jpgrismeyer/ProyectoFinal/Sensor integral para el cuidado de plantas-20250406T194602Z-001/Sensor integral para el cuidado de plantas/Informe/Imagenes/bh1750.png

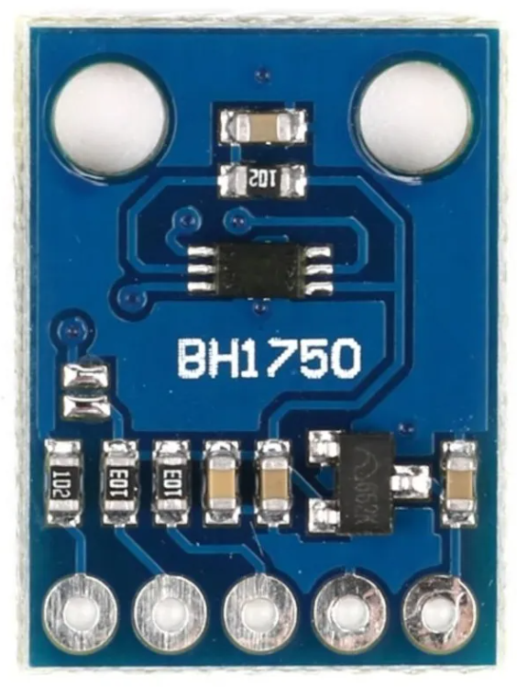
Sensor integral para el cuidado de plantas-20250406T194602Z-001/Sensor integral para el cuidado de plantas/Informe/Imagenes/bh1750.png
