jpgrismeyer/ProyectoFinal/Sensor integral para el cuidado de plantas-20250406T194602Z-001/Sensor integral para el cuidado de plantas/Sensor De Humedad De Sustrato.docx

# Sensor inteligente de humedad de sustrato de bajo costo

Sensor De Humedad De Sustrato - Xiaomi Mi Flora - Growing | Envío gratis (mercadolibre.com.ar) (https://articulo.mercadolibre.com.ar/MLA-1114325165-sensor-de-humedad-de-sustrato-xiaomi-mi-flora-growing-_JM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)

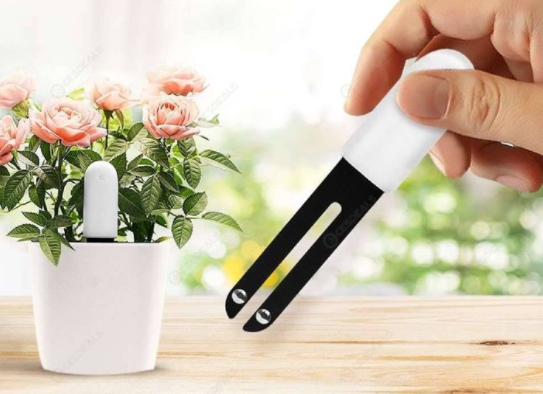
[picture p3: figure]

Sensor de humedad capacitivo:

Sensor De Humedad En Suelo - Capacitivo Analogico Gtia | MercadoLibre (https://articulo.mercadolibre.com.ar/MLA-806079200-sensor-de-humedad-en-suelo-capacitivo-analogico-gtia-_JM) ADC

Sensor de temperatura:

LM35 + acondicionamiento de señal (tarda 3 minutos en tener un valor 100% final) ADC

Termistor NTC + acondicionamiento de señal ADC

Sensor de luz:

Modulo Sensor De Luz Digital Ambiente Bh1750 Gy-302 Arduino | MercadoLibre (https://articulo.mercadolibre.com.ar/MLA-905448482-modulo-sensor-de-luz-digital-ambiente-bh1750-gy-302-arduino-_JM) I2C

LDR + acondicionamiento de señal (es necesario calibrar?) ADC

Microcontrolador:

Tiene que soportar: I2C, ADC (Ver STM32F103)

Display OLED:

Pantalla Oled Display 0.96p Arduino Raspberry Arm I2c Iic Se | MercadoLibre (https://articulo.mercadolibre.com.ar/MLA-743257264-pantalla-oled-display-096p-arduino-raspberry-arm-i2c-iic-se-_JM) I2C

Batería:

Accesorio Drone Bateria Litio Polimero Lipo 3.7v 2000mah | MercadoLibre (https://articulo.mercadolibre.com.ar/MLA-933373386-accesorio-drone-bateria-litio-polimero-lipo-37v-2000mah-_JM)
