jpgrismeyer/ProyectoFinal/Sensor integral para el cuidado de plantas-20250406T194602Z-001/Sensor integral para el cuidado de plantas/Presentación/Discurso.docx

Enzo:

Bienvenidos, gracias por asistir. Mi nombre es Enzo Manolucos y con mi compañero hoy presentaremos nuestro proyecto final de grado, llamado:

Sensor integral para el cuidado de plantas

Los temas tratados en esta presentación serán:

Introducción a la problemática y la solución propuesta

Objetivo del proyecto

Estado del arte, donde veremos los productos existentes

Diseño del sistema, nuestra propuesta para abordar la problemática

El dispositivo de medición que construimos

Y finalmente la aplicación final y conclusiones

Las plantas dentro del hogar nos generan la sensación de tener contacto con la naturaleza. Estas resultan de gran ayuda para las personas por diversos motivos, entre ellos tenemos:

Debido a esta necesidad cada vez es más común adquirir distintas especies de plantas. Algunas más conocidas son:

Potus, monstera, marginata, alocasia, calathea, suculentas, cactus, penca, etc.

Al tener tanta variedad de especies en el mercado, se necesitan distintos tipos de cuidados. Ciertas especies son muy caras de adquirir y lo que uno quiere es que la planta tenga un buen estado de salud.

Los principales problemas en el cuidado de salud de las plantas son:

Exceso de riego, quemaduras solares y/o demasiada luz

Es primordial acondicionar el ambiente hogareño al hábitat de la especie en cuestión

Por lo tanto el objetivo de nuestro proyecto es:

Desarrollar un dispositivo capaz de medir la luz incidente, humedad del sustrato, temperatura del sustrato y temperatura ambiente de una planta.

Con esta información el usuario va a tener detalles precisos de como cuidar y qué hacer con su planta.

En el mercado existen productos similares, con otras características. Principalmente estos necesitan de un smartphone para transmitir los datos, además de tener conexión WiFi. Xiaomi tiene Mi Flora con ronda los los 25 USD y Parrot tiene Flower Power que ronda los 50 USD.

Ver la filmina de grismeyer jeje.

El diseño del sistema se basa principalmente en sensores que toman datos de los plantos, su procesamiento y la visualización de la información para el usuario.

En base a esto los requerimientos propuestos son:
