jpgrismeyer/ProyectoFinal/Sensor integral para el cuidado de plantas-20250406T194602Z-001/Sensor integral para el cuidado de plantas/Informe/backup_30_06/ProyectoFinal_2022.pdf

### UNIVERSIDAD TECNOLOGICA NACIONAL ´

### FACULTAD REGIONAL CORDOBA ´

## Departamento de Ingeniería Electrónica

## Cátedra de Proyecto Final

## Informe

sensor integral para

el cuidado de plantas

## Integrantes

## Grismeyer, Juan Pablo Manolucos, Enzo Nicolas

## Director

## Riva, Guillermo

## Docentes

## Galleguillo, Juan Cayetano del Corazón Gaydou, David Encina, Lucas

# 1 de julio de 2022

## Juan Pablo Grismeyer - Enzo Nicolas Manolucos

Proyecto Final, © Julio 2022.

Cátedra de Proyecto Final | Informe

## Índice

1. Introducción | 3
2. Objetivo del proyecto | 4
3. Estado del arte | 5
3.1. Productos comerciales | | 5
3.2. Conclusión | | 5
4. Diseno del sistema | 6 ˜
4.1. Requerimientos | | 6
4.2. Etapas de desarrollo | | 7
5. Dispositivo de medición | 8
5.1. Prototipo I | | 8
5.2. Prototipo II | | 9
5.3. Diseño Final | | 9
| 5.3.1. Microcontrolador ESP8266 | | 9
| 5.3.2. Sensor de humedad y temperatura SHT20 | | 9
| 5.3.3. Sensor de luz BH1750 | | 9
| 5.3.4. Sensor de temperatura LM35 | | 9
| 5.3.5. Fuente de alimentación regulada | | 9
5.4. Firmware | | 9
6. Aplicación Final | 10
7. Conclusión | 11
8. Referencias | 12

## Figuras

1. | Plantas de interior | | 3
2. | Ejemplos de cuidado incorrecto de las plantas | | 4
3. | Productos comerciales | | 5
4. | PCB del prototipo I | | 8
5. | Esquemático del ESP8266 | | 9
6. | ESP8266 | | 10
7. | Esquemático de la fuente | | 10
8. | Diagrama en bloques del dispositivo | | 11

## Tablas

1. | Niveles de humedad, luz y temperatura según la especie | | 6

## 1. Introducción

En el contexto actual donde la sociedad pasa mayor tiempo dentro de sus hogares, se genera la necesidad de tener cierto contacto con la naturaleza a través de plantas dentro del mismo. Las plantas resultan de gran ayuda para el ser humano por diversos motivos, algunos son:

Limpian el ambiente y regulan la humedad

Ayudan contra el estrés y potencian la concentración

Tiene propiedades antisépticas y calmantes

Aportan una buena imagen en la decoración

Sirven para utilizar en comidas

Reducen el ruido

Ciertas especies ganaron más popularidad en estos últimos tiempos, como por ejemplo, potus, monstera, marginata, alocacia, sansevieras, calathea, suculentas, cactus, tradiscantia, penca, singonia, etc, algunas de las cuales se aprecian en la Figura 1.
Al tener tanta variedad de especies en el mercado, estas llevan distintos cuidados. Adquirir ciertas especies implica una elevada inversión y por lo tanto cuidarlas para mantenerlas saludables. Un mal cuidado puede derivar en la muerte de la misma.

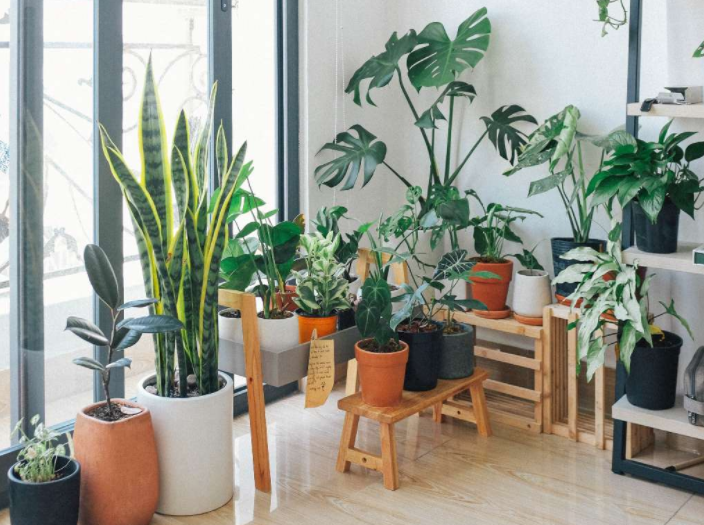
[picture p4: figure]

Figura 1: Plantas de interior.

La principal causa de muerte de las plantas de interior es el exceso de agua cuando se las riega. Un exceso de agua corta el suministro de airea a las raíces, elimina los nutrientes necesarios y crea el ambiente perfecto para hongos conduciendo a que se pudra la raíz (Figura 2a). Por otro lado, la falta de riego es tan perjudicial como el exceso de riego. Esto produce que las hojas se vean caídas, secas o que se pongan de color amarillo debido a que las plantas intentan conservar la poca agua que tienen para el tallo y raíces, descuidando las hojas. Existe una delgada linea entre riego excesivo y riego insuficiente por lo que es difícil medir las necesidades precisas de cada planta.
Al momento de cuidar plantas, lo ideal es tratar de imitar el entorno natural de estas. Por ejemplo, ciertas plantas que prosperan en el desierto necesitan sol pleno y poca agua, otras necesitan grandes niveles de humedad y sol indirecto para imitar un ambiente tropical. Un exceso de luz provoca que las hojas se curven hacia abajo, se doran las puntas o que las nuevas hojas sean más pequeñas que las anteriores (Figura 2b). Si por el contrario hay poca luz las hojas carecen de color y su tamaño es cada vez más pequeño.
La temperatura es otro factor a tener en cuenta. Las altas temperaturas y el exceso de luz directa pueden provocar quemaduras (Figura 2c), las cuales provoca daños irreparables y eventualmente la muerte de la planta. Temperaturas demasiada bajas dañan el crecimiento y provocan la muerte de las plantas.

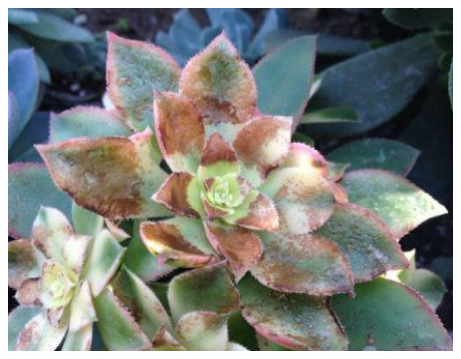
[picture p5: figure]
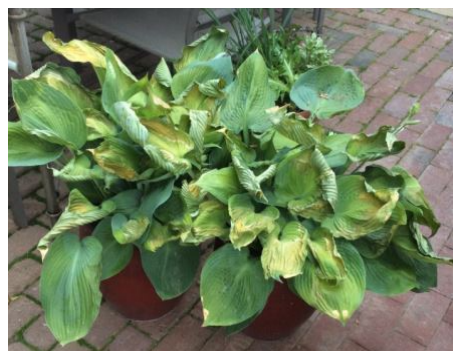
[picture p6: figure]
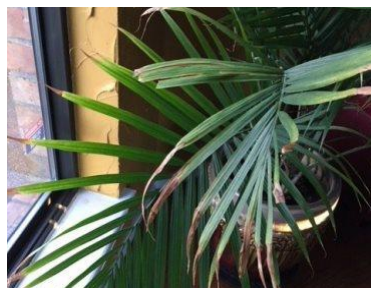
[picture p7: figure]

(a) Exceso de riego | (b) Demasiada luz | (c) Quemadura solar

Figura 2: Ejemplos de cuidado incorrecto de las plantas.

Estos tres factores son los más importantes al momento de cuidar una planta para conservar su estado de salud, su correcta reproducción y longevidad.

## 2. Objetivo del proyecto

Desarrollar un dispositivo capaz de medir la humedad del sustrato, temperatura ambiente y luz incidente sobre una planta, que pueda comunicar estos parámetros al usuario mediante una interfaz simple.

## 3. Estado del arte

Diversas empresas se dedican al desarrollo de sistemas aplicados al cuidado de plantas. Existen productos en fase de desarrollo y otros ya disponibles en el mercado. Estos se utilizan para el análisis y la toma de decisiones para el correcto cuidado de las plantas. Todos los productos actualmente en el mercado están sujetos a una aplicación móvil que permita visualizar los datos. La principal desventaja de esto es que se requiere de un teléfono móvil con conexión a internet y algún tipo de comunicación, ya sea WiFi o Bluetooth.

### 3.1. Productos comerciales

La empresa china Xiaomi posee en el mercado un dispositivo llamado Mi Flora (Figura 3a) que es utilizado para plantas de interior. Este tiene monitor de temperatura, humedad y detectores de luz y nutrientes. Su principal característica es la integración con IOT. El precio ronda los 25USD.
La empresa francesa Parrot posee en el mercado un dispositivo llamado Flower Power (Figura 3b) que también es utilizado para plantas de interior y exterior. Puede medir humedad, temperatura y luz. Además da recomendaciones de los cuidados de la planta según una base de datos. El precio ronda los 50USD.

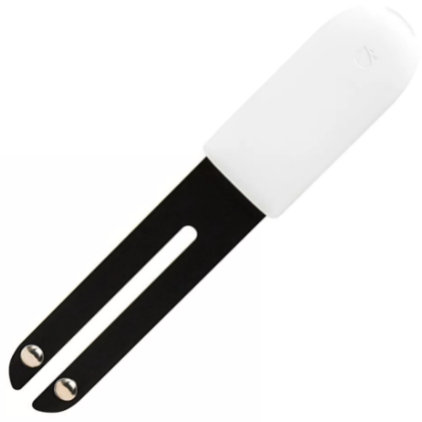
[picture p8: figure]
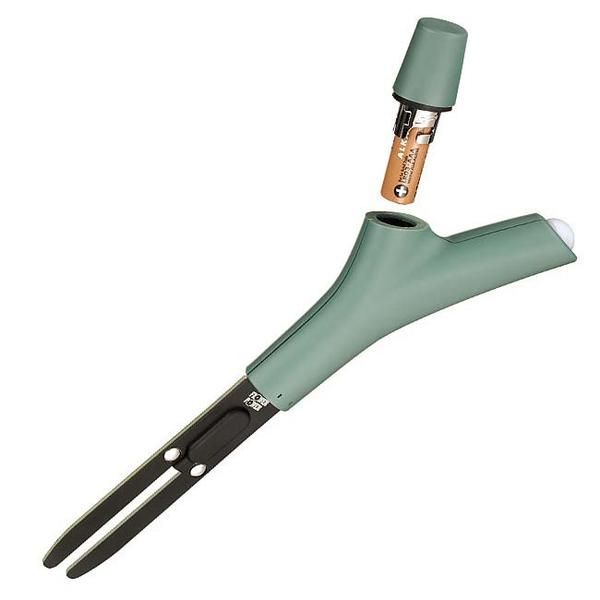
[picture p9: figure]

(a) Mi Flora | (b) Flower Power

Figura 3: Productos comerciales

### 3.2. Conclusión

Los productos del mercado relacionados a nuestro proyecto no son abundantes, principalmente en nuestro país. Además, su precio es elevado y la adquisición de la mayoría implica una importación. Esto representa una gran oportunidad en la introducción al mercado de nuestro producto, con la gran importancia que este posee en nuestro país.

## 4. Diseño del sistema

Como punto de partida, se propuso un sistema a nivel conceptual cuyo diagrama en bloques se muestra en la Figura . Este consistió en un conjunto

### 4.1. Requerimientos

En busca de un objetivo bien definitivo para el desarrollo del producto, se plantearon una serie de requerimientos para los diversos bloques del sistema. Esto permitiría en ele futuro a tener cierto grado de criterio al comparar tecnologías, dispositivos, fabricantes, entre otros aspectos. Se propone un sistema que mesure estos parámetros con sensores lo más simples posibles y fáciles de manipular, para que luego de acondicionar esas señales y del procesamiento de datos, el usuario pueda acceder a esta información de manera sencilla.
La idea es que el dispositivo integre los sensores necesarios y los circuitos acondicionadores para que mediante el control de un integrado, se ejecute las mediciones en una planta y se obtengan los datos en la interfaz de forma automática, en un corto lapso de tiempo.
El dispositivo está pensado para efectuar relevos individuales, es decir, controlar las variables de una planta a la vez. El usuario se debe encargar de hacer interactuar el dispositivo con el sustrato en cuestión, y una vez que ponga en marcha el sistema, en la interfaz entre el dispositivo y el usuario se exhiban de manera automática los datos requeridos.
El modelo en cuestión sólo informará acerca de los valores de los parámetros en cuestión, lo más preciso y rápido posible. El usuario debe saber como interpretar esos datos, si se adecúa a lo esperado y en que rango el parámetro en cuestión sería óptimo de acuerdo a las características de cada planta en específico.
Se tiene que obtener un producto que se pueda transportar de sustrato en sustrato para hacer las mediciones, que trabaje en condiciones ambientes de interior, y que su autonomía permita realizar las mediciones de las plantas del hogar de manera práctica y eficiente.
Segun [1], la humedad del sustrato/suelo se mide como el volumen de agua que hay en cierto volumen de tierra, se lo conoce como VWC, Contenido Volumétrico de Agua. En general, un nivel del 50 % se considera saturado, es decir, ya es demasiada agua en el sustrato para una planta. El dispositivo debe cumplir con los siguientes requerimientos:
Tipo | Humedad del sustrato | Luz | Temperatura [±2 ◦C]
Alocasia | Alta | Media (Ind) | 20 - 28
Cactus | Baja | Alta (Dir/Ind) | 5 - 35
Calathea | Media | Alta (Ind) | 18 - 24
Marginata | Media/Alta | Media (Ind) | 22 - 26
Monstera | Media/Alta | Alta (Ind) | 18 - 27
Penca | Baja | Alta (Dir/Ind) | 15 - 30
Potus | Alta | Alta (Ind) | 17 - 30
Sansevieria | Media | Alta (Dir) | 15 - 30
Suculentas | Media | Alta (Dir/Ind) | 4 - 27
Tradescantia Media | Alta (Ind) | 20 - 30

Tabla 1: Niveles de humedad, luz y temperatura según la especie.

Humedad del sustrato: Poder medir en un rango de 0 al 60 %. La precisión dentro de este rango de medición será del 5 %.

Temperatura: Poder realizar mediciones en el rango de 0°C a 50°C. La precisión dentro de este rango de medición será de al menos 0,5°C.

Luz: Poder medir de 0 a 20.000lx. La precisión dentro de este rango será de al menos 1 lx.

Condiciones de trabajo: Trabajar óptimamente con humedad ambiente relativa de 0 a 70 %.

Autonomía: 6hs mediante baterías.

Tamaño: Debe tener un tamaño mínimo así es posible manipularlo con una sola mano

Visualización de datos: Reflejar actualizaciones de los parámetros precisas al menos cada 10 segundos, de modo que no sea muy tediosa la adaptación y corrección de alguno de los factores que esté fuera de rango óptimo.

Tamaño

lo del anteproyecto

### 4.2. Etapas de desarrollo

Para llevara cabo el proyecto se propuso un esquema de dos etapas que permitiesen evaluar paso a paso las distintas alternativas y tecnologías que podrían dar solución a la problemática:

1. Etapa I: investigar y desarrollar un sistema para prueba de concepto. El objetivo fue analizar, en un periodo de tiempo muy corto, la factibilidad del producto sin tener en cuenta tecnologías ni requerimiento estrictos.
2. Etapa II: evaluar las tecnologías que cumplen los requerimientos planteados. Para esta etapa el objetivo planteado consistió en definir todas las tecnologías, circuitos y drivers para luego implementarlas en el producto final.
3. Etapa III: concentrar todos los circuitos implementados en la etapa anterior en un producto final.

## 5. Dispositivo de medición

El dispositivo electrónico portátil es el encargado de...
El desarrollo de este dispositivo constó de tres etapas. Cada una de estas perseguía distintos objetivos. La etapa inicial buscó evaluar la factibilidad de la idea. En la segunda etapa se evaluaron diversas tecnologías para la aplicación y se descartaron otras. Por último, en la tercera etapa se optimizaron los diseños realizados en las etapas anteriores y se diseñó un primer prototipo de producto.

### 5.1. Prototipo I

Primero se desarrollo este primer prototipo que tuve como objetivo evaluar la factibilidad del producto y seleccionar los sensores óptimos acordes a los requisitos del mismo.
El sensor propuesto para medir la humedad y temperatura del sustrato fue el SHT20. Este es un dispositivo electrónico combina un sensor capacitivo para la humedad, un sensor band gap de temperatura y un circuito analógica digital dedicado. El sensor propuesto para medir la luz fue el BH1750. Este dispositivo electrónico utiliza un sensor digital para medir la luz. Finalmente el sensor propuesto para medir la temperatura ambiente fue el LM35. Este dispositivo electrónico contiene un circuito integrado capaz de medir en Centígrados.
En esta etapa se diseño una plataforma con un microcontrolador que permitió interactuar con los sensores, registrar la información proveniente de los mismos y luego, mostrar estos datos en un display de 16x2. El diagrama en bloques de este prototipo se presenta en la Figura.
Se utilizo la plataforma Arduino UNO que contiene el microcontrolador ATmega328P, ya que el uso de esta arquitectura permite utilizar todas las funciones rápidamente debido a su gran desarrollo. Para la integración de todos los módulos comerciales, se diseño un PCB como el que se presenta en la Figura 4.

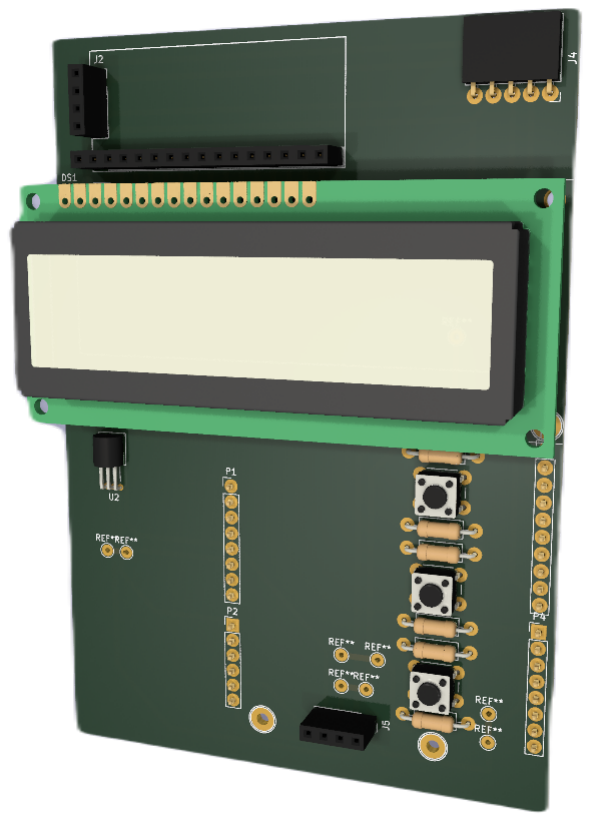
[picture p10: figure]

Figura 4: PCB del prototipo I.

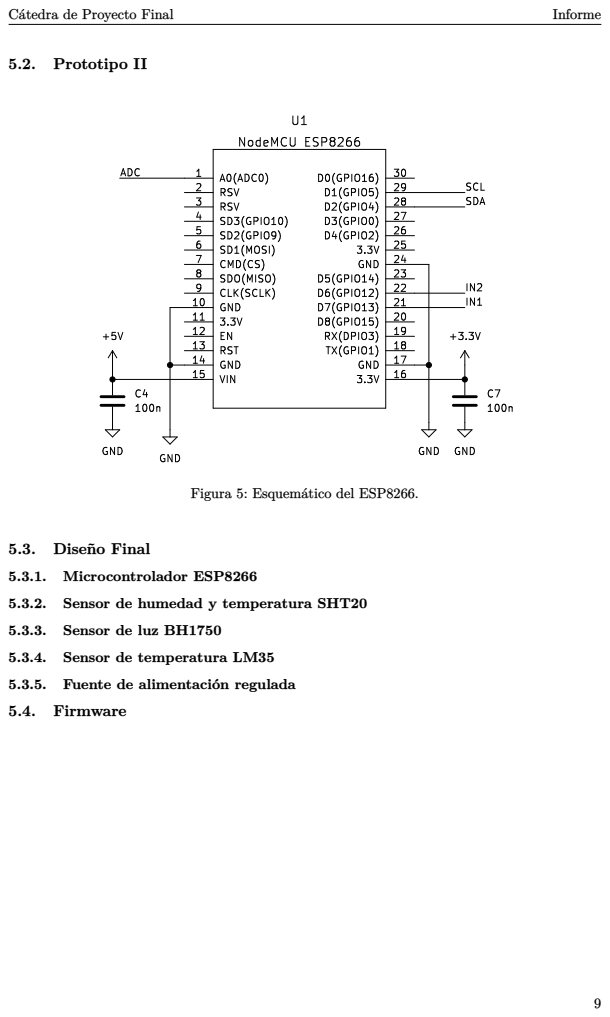
[picture p11: page 10]
5.2. Prototipo II; 5.3.1. Microcontrolador ESP8266; Sensor; de humedad; y temperatura SHT20; de luz BH1750; de temperatura LM35; Fuente; de alimentación regulada; 5.4. Firmware

Figura 5: Esquemático del ESP8266.

5.3. Diseño Final

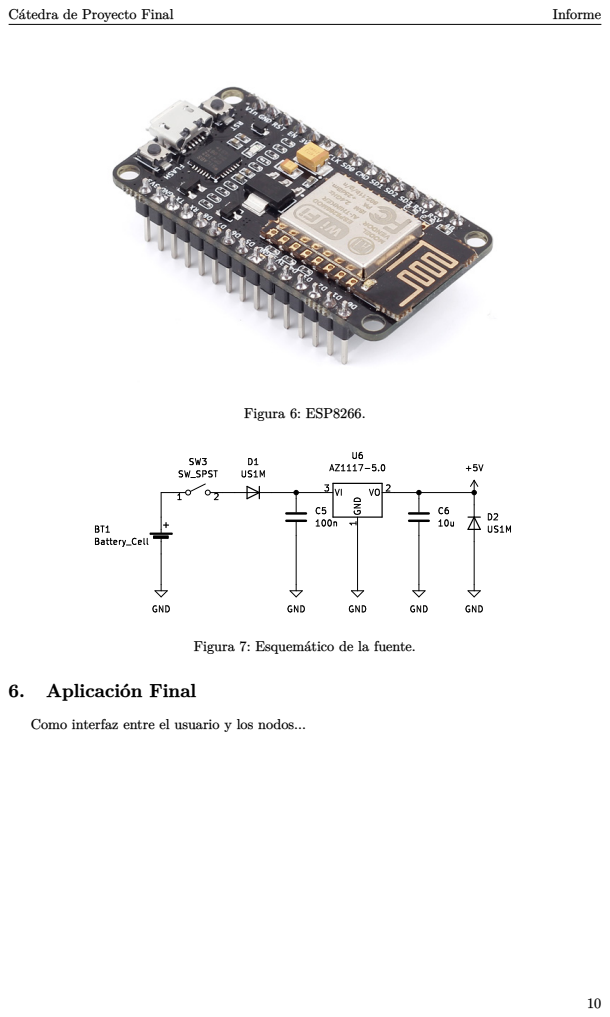
[picture p12: page 11]
Figura 6: ESP8266.

Figura 7: Esquemático de la fuente.

6. Aplicación Final

Como interfaz entre el usuario y los nodos...

## 7. Conclusión

En la Figura 8 se presenta el diagrama en bloques del dispositivo a desarrollar. A continuación se detalla la función de cada uno:

Sensores: se encargan de realizar la medición de las variables humedad, temperatura y luz.

- Humedad del sustrato: Se piensa en el sensor SHT20 que abarca el rango de medición requerido, y tiene una precisión del 3 %. El integrado se ubica dentro de un encapsulado especial para poder ser insertado en la tierra. Salida digital I²C.
- Temperatura: Se piensa en el sensor LM35 que abarca el rango de medición requerido, y tiene una precisión del 3°C. Salida analogica.
- Luz: Se elige el sensor GY-302, que trabaja con el chip BH1750, y tiene salida I2C. El sensor abarca el rango de medición requerido con una precisión de hasta 0,5 lx.

Acondicionamiento de señal: convierte la medición de los sensores en datos para luego ser procesados por el ADC en la etapa de control.

Control: adquiere y procesa los datos provenientes de los sensor para obtener las mediciones. Cuenta con ADC y protocolo de comunicación I²C.

Interfaz: sera la interfaz entre el usuario y el dispositivo para poder iniciar y configurarlo. Posee una pantalla OLED con comunicación I²C o SPI y pulsadores para el manejo de la

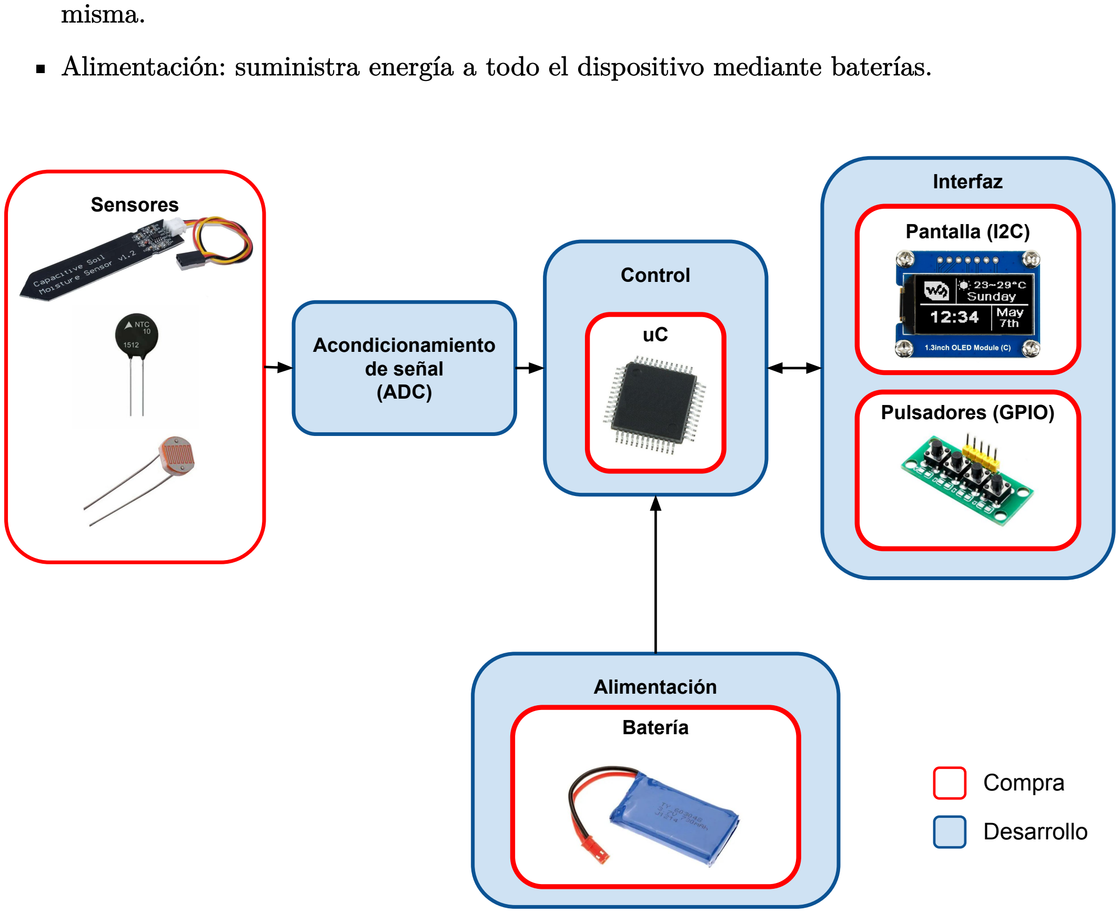
[picture p13: figure]
misma.; Sensores; Acondicionamiento de señal (ADC); Control; Interfaz; Pantalla (I2C); Pulsadores (GPIO); Alimentación; Batería; Compra; Desarrollo

Alimentación: suministra energía a todo el dispositivo mediante baterías.

Figura 8: Diagrama en bloques del dispositivo.

Cosas que hay que poner Glosario, Anexo

## 8. Referencias

[1] Franco Castro, Mayco Cussa, Facundo Navarro, and Jonathan Nobile. Monitoreo de variables de suelo para control fúngico en campos de azafrán. UTN - Facultad Regional Córdoba, 2021.
