jpgrismeyer/ProyectoFinal/Sensor integral para el cuidado de plantas-20250406T194602Z-001/Sensor integral para el cuidado de plantas/dibujo_prototipo_JE.pdf

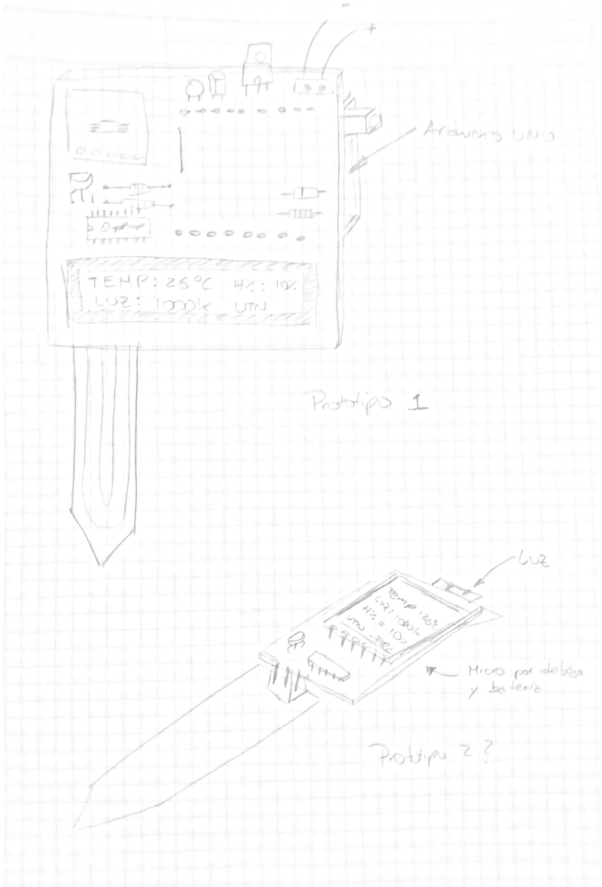
[picture p14: page 1]
