jpgrismeyer/ProyectoFinal/Sensor integral para el cuidado de plantas-20250406T194602Z-001/Sensor integral para el cuidado de plantas/Anteproyecto/Gantt_Grismeyer_Manolucos_actualizado.pdf

1 | Proyecto Final de Grado | 87 days? | 01/04/22 08:00 | 08/07/22 17:00
2 | Etapa I | 43 days? | 01/04/22 08:00 | 13/05/22 17:00
3 | relevar sensores | 7 days? | 01/04/22 08:00 | 07/04/22 17:00
4 | comprar | 4 days? | 08/04/22 08:00 | 11/04/22 17:00 | 3
5 | prueba individual de cada sensor | 2 days? | 12/04/22 08:00 | 13/04/22 17:00 | 4
6 | calibración | 2 days? | 12/04/22 08:00 | 13/04/22 17:00 | 4
7 | acondicionamiento de señales p/ arduino | 3 days? | 14/04/22 08:00 | 16/04/22 17:00 | 6;5
8 | diseño | 8 days? | 17/04/22 08:00 | 24/04/22 17:00 | 7
9 | compra de componentes | 4 days? | 25/04/22 08:00 | 28/04/22 17:00 | 8
10 | programación arduino | 11 days? | 29/04/22 08:00 | 09/05/22 17:00 | 9
11 | montaje prototipo 1 | 12 days? | 29/04/22 08:00 | 10/05/22 17:00 | 9
12 | evaluacion prototipo 1 | 15 days? | 29/04/22 08:00 | 13/05/22 17:00 | 9
13 | Etapa II | 44 days? | 14/05/22 08:00 | 08/07/22 17:00 | 12
14 | identificar fallas en prototipo 1 | 4 days? | 14/05/22 08:00 | 17/05/22 17:00
15 | relevar micros | 4 days? | 14/05/22 08:00 | 17/05/22 17:00
16 | diseñar prototipo 2 con mejoras y acord... | 8 days? | 18/05/22 08:00 | 25/05/22 17:00 | 15;14
17 | comprar micro | 4 days? | 26/05/22 08:00 | 31/05/22 17:00 | 16
18 | diseñar pcb | 5 days? | 01/06/22 08:00 | 07/06/22 17:00 | 16;17
19 | comprar demás componentes | 2 days? | 08/06/22 08:00 | 09/06/22 17:00 | 18
20 | confeccionar placa | 5 days? | 10/06/22 08:00 | 16/06/22 17:00 | 19
21 | soldar | 2 days? | 17/06/22 08:00 | 20/06/22 17:00 | 20
22 | pruebas y presentar | 4 days? | 21/06/22 08:00 | 24/06/22 17:00 | 21
23 | Confeccion de informe | 5 days? | 27/06/22 08:00 | 01/07/22 17:00 | 22
24 | Presentación | 1 day? | 08/07/22 08:00 | 08/07/22 17:00 | 23
Nombre | Duracion | Inicio | Terminado | Predecesores | Nombres del Recurso
M | M | J | V | S | D | L

4 abr 22
M | M | J | V | S | D | L

11 abr 22
M | M | J | V | S | D | L

18 abr 22
M | M | J | V | S | D | L

25 abr 22
M | M | J | V | S | D | L

2 may 22
M | M | J | V | S | D | L

9 may 22
M | M | J | V | S | D | L

16 may 22
M | M | J | V | S | D | L

23 may 22
M | M | J | V | S | D | L

30 may 22
M | M | J | V | S | D | L

6 jun 22
M | M | J | V | S | D | L

13 jun 22
M | M | J | V | S | D | L

20 jun 22
M | M | J | V | S | D | L

27 jun 22
M | M | J | V | S | D | L

4 jul 22
M | M | J | V | S | D | L
