jpgrismeyer/ProyectoFinal/Sensor integral para el cuidado de plantas-20250406T194602Z-001/Sensor integral para el cuidado de plantas/Informe/Imagenes/Anotación 2022-06-30 182313.png

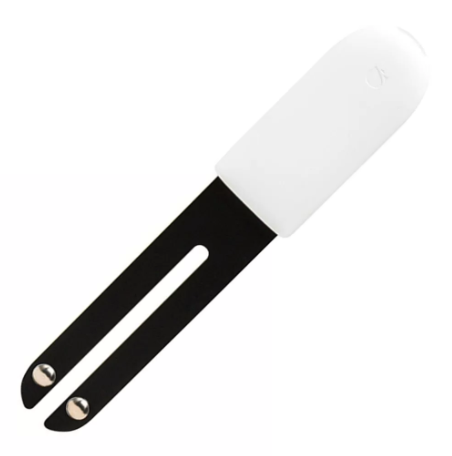
Sensor integral para el cuidado de plantas-20250406T194602Z-001/Sensor integral para el cuidado de plantas/Informe/Imagenes/Anotación 2022-06-30 182313.png
