jpgrismeyer/ProyectoFinal/Sensor integral para el cuidado de plantas-20250406T194602Z-001/Sensor integral para el cuidado de plantas/Presentación/Fotos/WhatsApp Image 2022-07-08 at 10.47.06 AM (1).jpeg

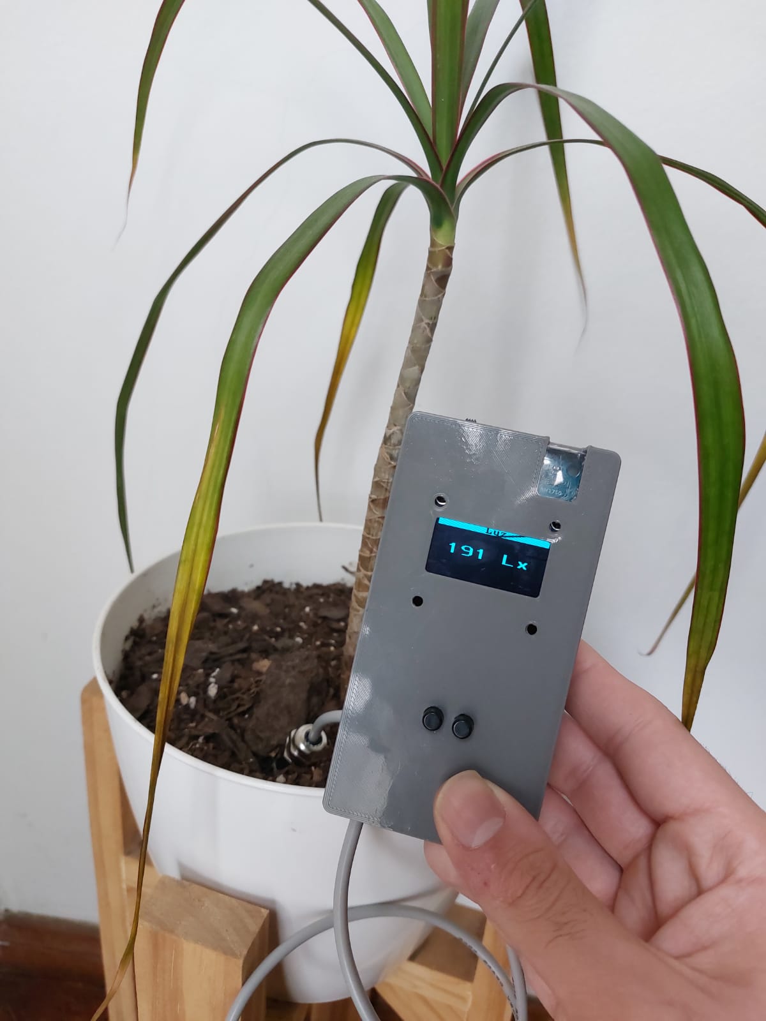
Sensor integral para el cuidado de plantas-20250406T194602Z-001/Sensor integral para el cuidado de plantas/Presentación/Fotos/WhatsApp Image 2022-07-08 at 10.47.06 AM (1).jpeg
