jpgrismeyer/ProyectoFinal/Sensor integral para el cuidado de plantas-20250406T194602Z-001/Sensor integral para el cuidado de plantas/Materiales.xlsx

Sheet: Compras feriado
Componente | Cantidad | Comentario
Hojas termotrasferencia A4 | 3 | Puede ser de otro tamaño. En Celsius tenian oficio
Placa FR4 20x10cm | 1 | Tamaño minimo
Tira de pines hembra 1x40 | 2
Switch pulsador largo | 3 | Hay unos con e boton más largo para meter en el gabitene. Alfa tiene ->
SHT20 con encalsupado | 1 | $8100, llega entre 27 y 30 de Junio

Sheet: SMD
Componente | Encapsulado | Cantidad | Link
Regulador AMS1117 5V | SOT-223 | 10
Capacitor 100n Y5V | 1206 | 100
Resistor 10k | 1206 | 100
Resistor 220 | 1206 | 100
Diodo S1M | DO-214 | 25
Bateria Lipo 7.4v 1500mah Drones | MercadoLibre (https://articulo.mercadolibre.com.ar/MLA-736416606-bateria-lipo-74v-1500mah-drones-_JM)
Componente
Alimentacion
Conector

Sheet: Compras
 | Enzo | Juan Pablo
Sensor SHT20 (con carcasa) | 8100
Componentes SMD | 3600
Mechas 0,5 y 1mm | 800
ESP8266 | 1634
Display OLED | 1914
Componentes (pinza y conectores) | 1651
Gabinete 3D | 700
Sensor SHT20 |  | 2654
Módulo I2C LCD |  | 376
Lm35 |  | 320
BH1750 (luz) |  | 701
Display OLED 2 | 2185
Carcasas |  | 1950
hojas, placa, tiras hembra |  | 974
tornillos, acetato |  | 270 | TOTAL | 27829
Gasto cada uno | 20584 | 7245
Debe | -6669.5 | 6669.5
