jpgrismeyer/ProyectoFinal/Sensor integral para el cuidado de plantas-20250406T194602Z-001/Sensor integral para el cuidado de plantas/Etapa II/Prototipo 3D/otras versiones/proyecto final tapa b.FCStd

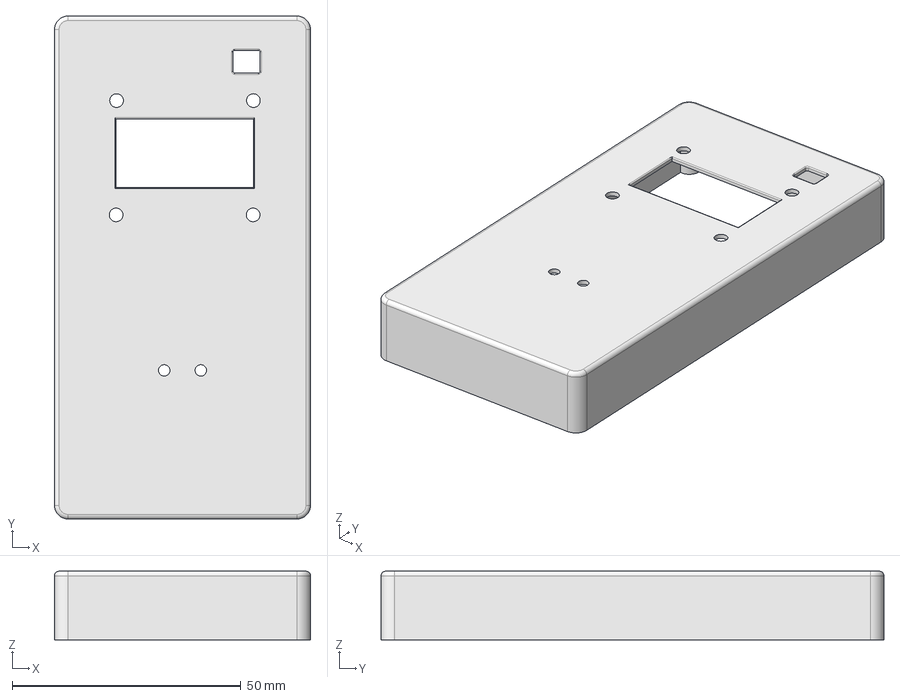
[picture p45: CAD file, 2025-04-06]
Sensor integral para el cuidado de plantas-20250406T194602Z-001/Sensor integral para el cuidado de plantas/Etapa II/Prototipo 3D/otras versiones/proyecto final tapa b.FCStd
56.0 x 110.0 x 15.0 mm
