jpgrismeyer/ProyectoFinal/(list of files, cad)

Other CAD files:
Sensor integral para el cuidado de plantas-20250406T194602Z-001/Sensor integral para el cuidado de plantas/Etapa II/Prototipo 3D/otras versiones/proyecto final base b.FCStd
Sensor integral para el cuidado de plantas-20250406T194602Z-001/Sensor integral para el cuidado de plantas/Etapa II/Prototipo 3D/proyecto final tapa c-Body.stl
Sensor integral para el cuidado de plantas-20250406T194602Z-001/Sensor integral para el cuidado de plantas/Etapa II/Prototipo 3D/otras versiones/proyecto final tapa c.FCStd
Sensor integral para el cuidado de plantas-20250406T194602Z-001/Sensor integral para el cuidado de plantas/Etapa II/Prototipo 3D/proyecto final tapa c.FCStd
Sensor integral para el cuidado de plantas-20250406T194602Z-001/Sensor integral para el cuidado de plantas/Etapa II/Prototipo 3D/proyecto final base b-Body.stl
