jpgrismeyer/ProyectoFinal/Sensor integral para el cuidado de plantas-20250406T194602Z-001/Sensor integral para el cuidado de plantas/Informe/Imagenes/bloques_prot1.pdf

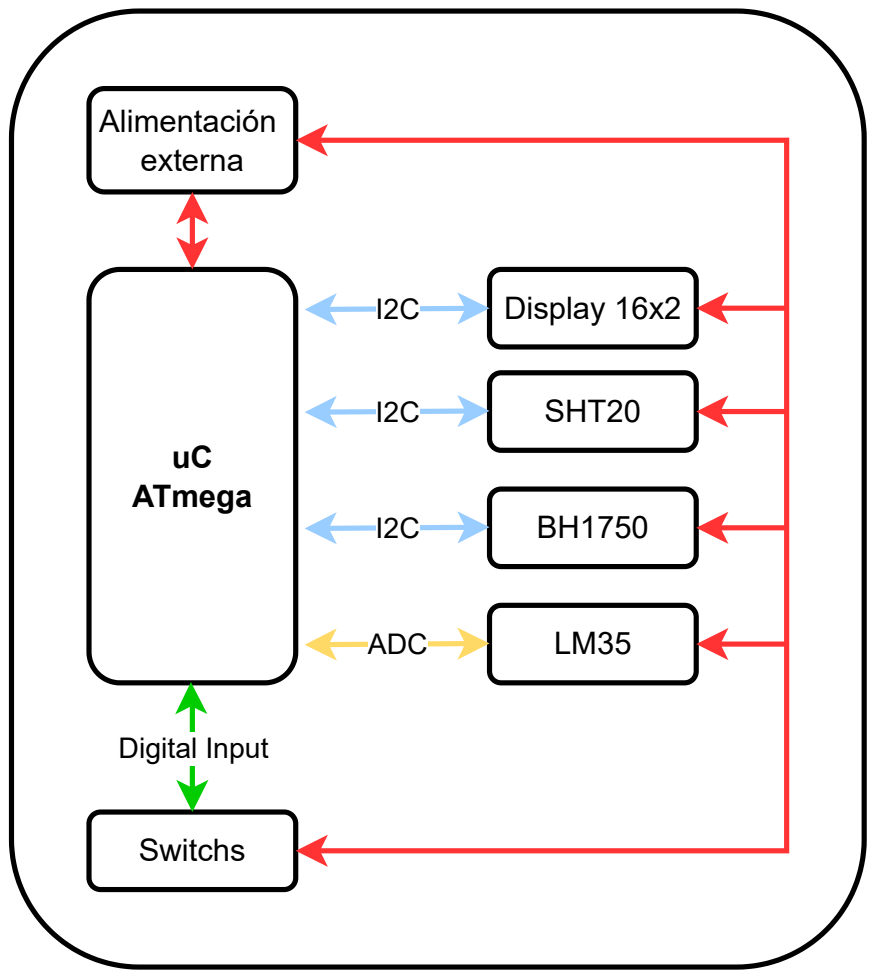
[picture p47: page 1]
uC ATmega; SHT20; Display 16x2; Alimentación externa; Switchs; ADC; Digital Input
