jpgrismeyer/ProyectoFinal/Sensor integral para el cuidado de plantas-20250406T194602Z-001/Sensor integral para el cuidado de plantas/Informe/Imagenes/bloques_prot2.pdf

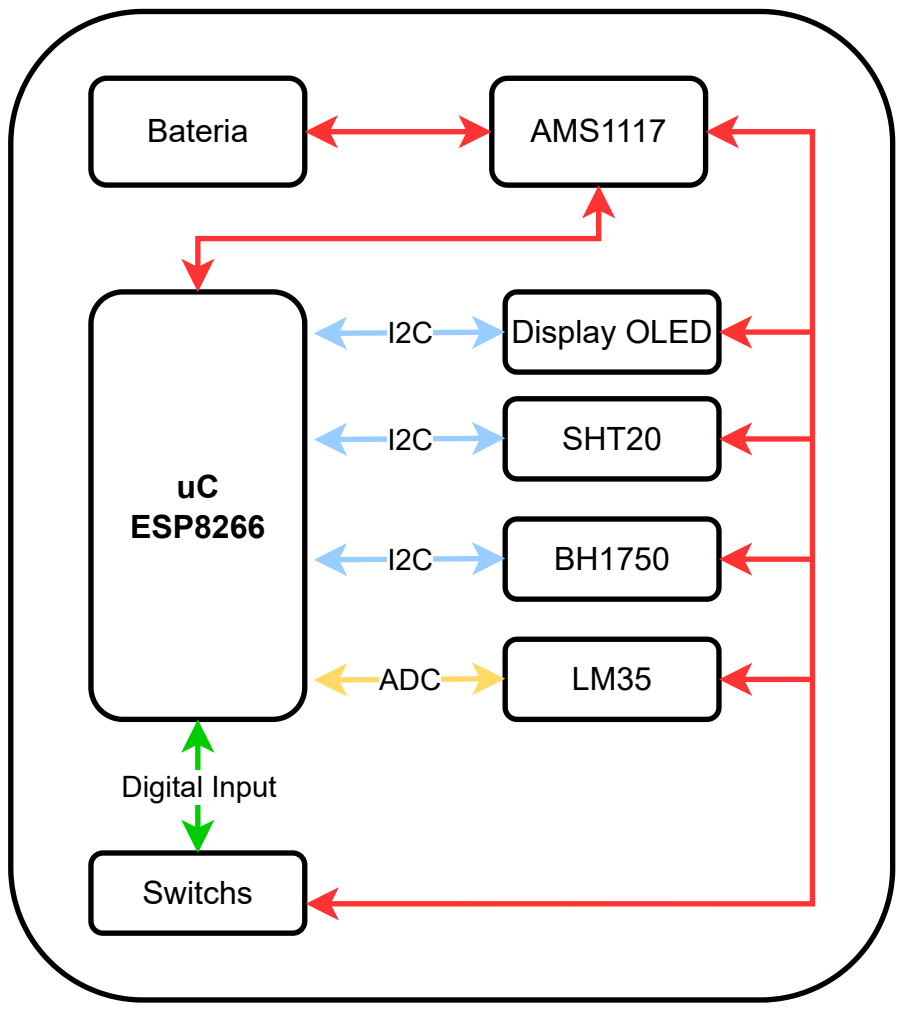
[picture p48: page 1]
uC ESP8266; SHT20; Display OLED; Bateria; Switchs; ADC; Digital Input; AMS1117
