jpgrismeyer/ProyectoFinal/Sensor integral para el cuidado de plantas-20250406T194602Z-001/Sensor integral para el cuidado de plantas/Informe/Imagenes/Draw.io/sistema.pdf

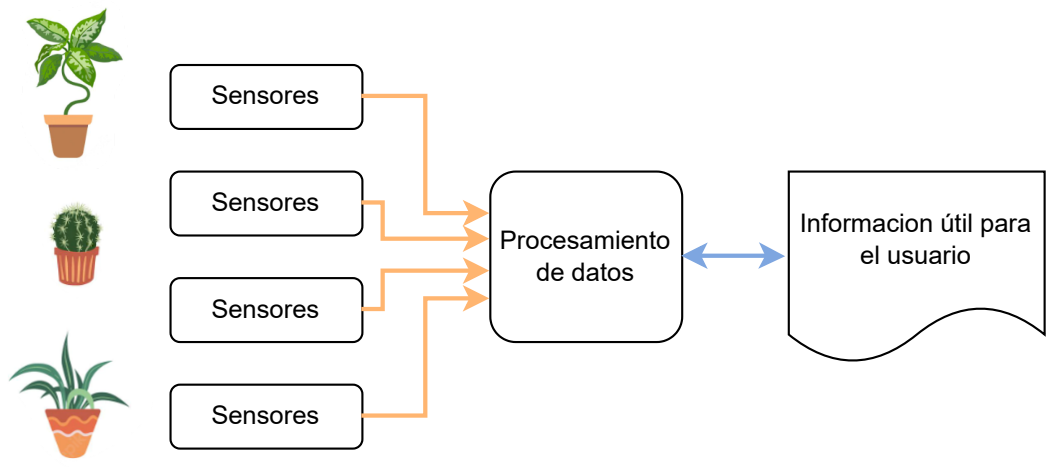
[picture p50: page 1]
Sensores; Procesamiento de datos

Informacion útil para
el usuario
