jpgrismeyer/ProyectoFinal/Sensor integral para el cuidado de plantas-20250406T194602Z-001/Sensor integral para el cuidado de plantas/Etapa II/Schematic_v1.pdf

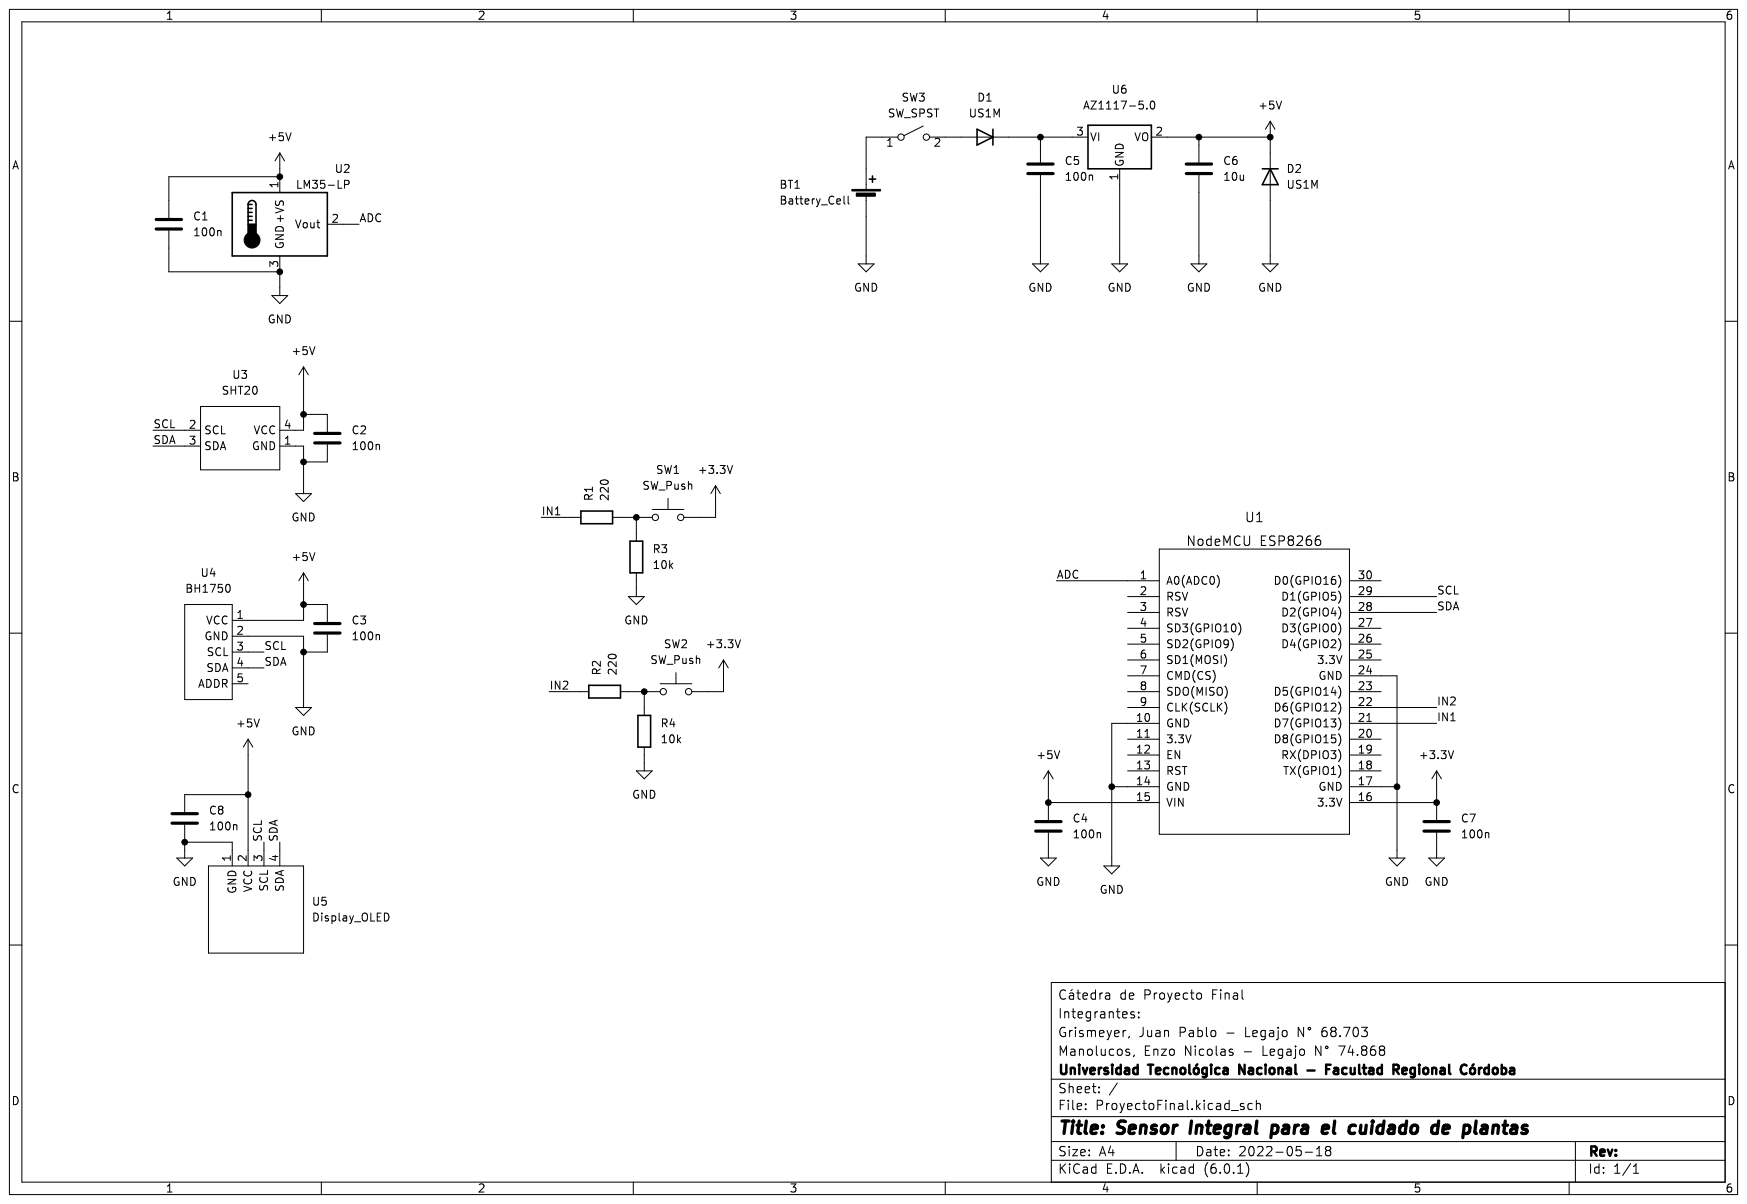
[picture p51: page 1]
