jpgrismeyer/ProyectoFinal/Sensor integral para el cuidado de plantas-20250406T194602Z-001/Sensor integral para el cuidado de plantas/Anteproyecto/Carátula_Grismeyer_Manolucos.pdf

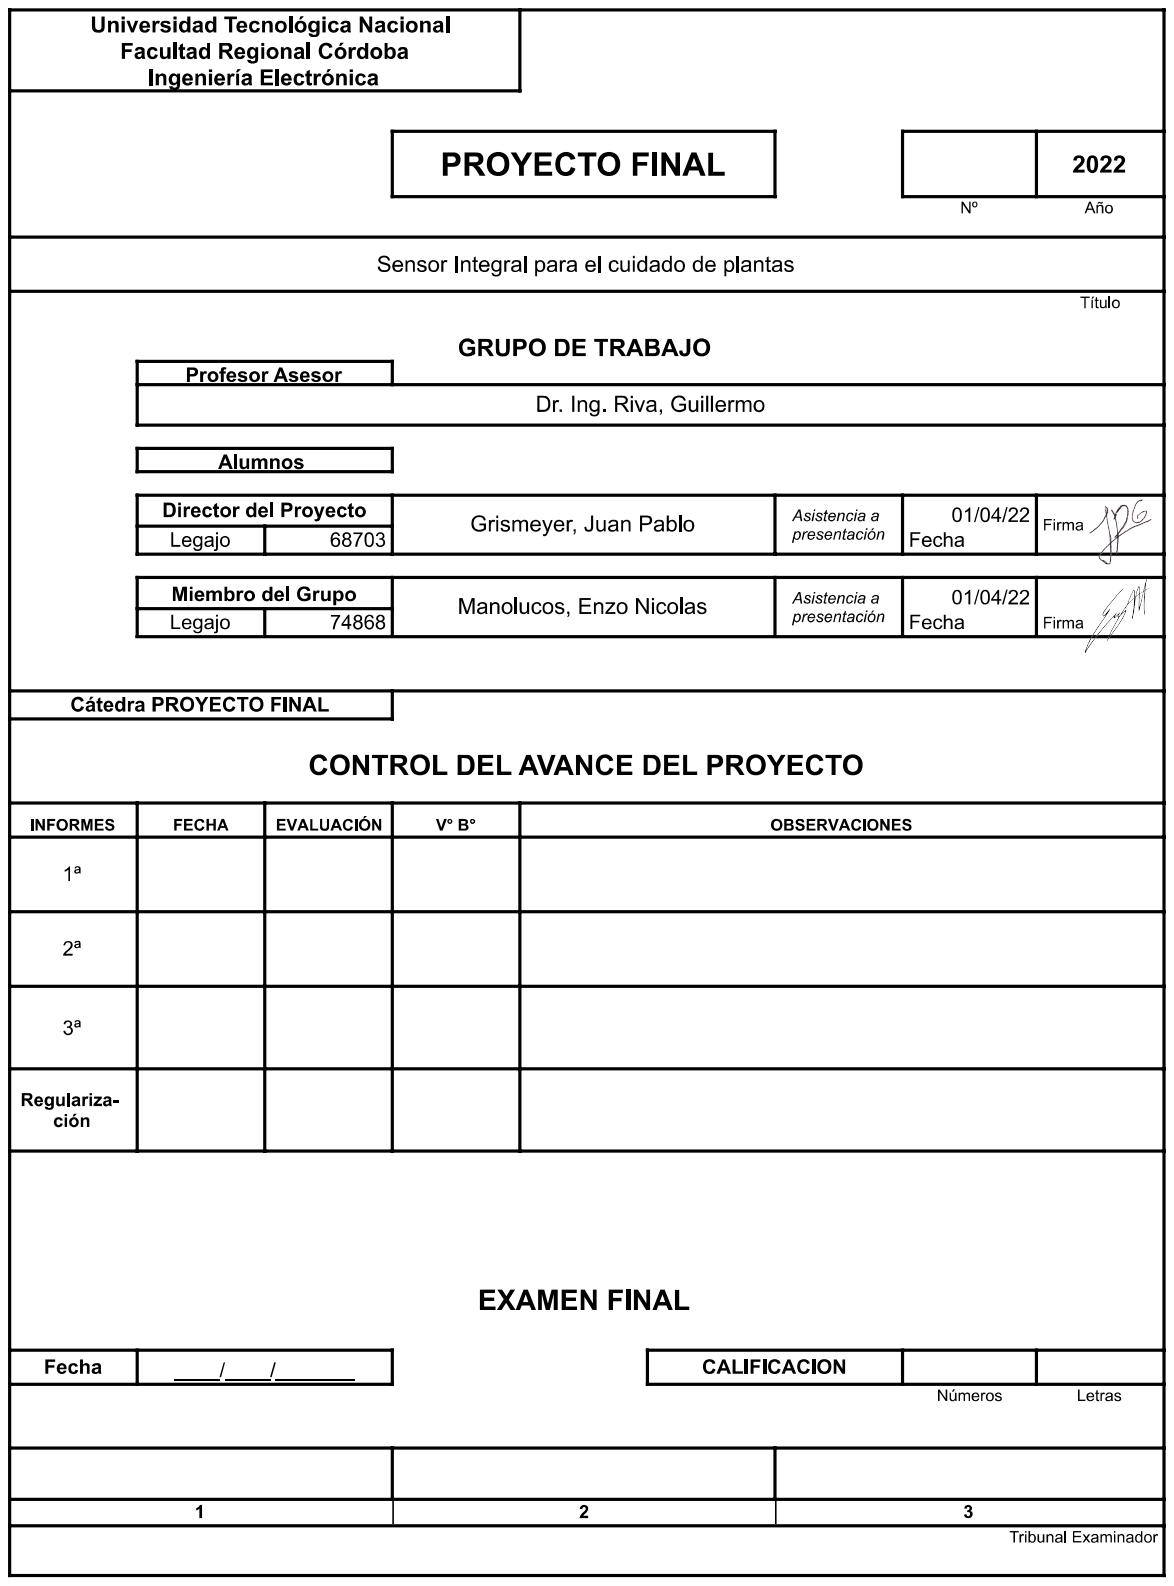
[picture p56: page 1]
