jpgrismeyer/ProyectoFinal/Sensor integral para el cuidado de plantas-20250406T194602Z-001/Sensor integral para el cuidado de plantas/Etapa II/PCB_V1/ProyectoFinal/ProyectoFinal.kicad_pcb

## KiCad design Sensor integral para el cuidado de plantas-20250406T194602Z-001/Sensor integral para el cuidado de plantas/Etapa II/PCB_V1/ProyectoFinal/ProyectoFinal.kicad_pcb (2025-04-06, an earlier design)

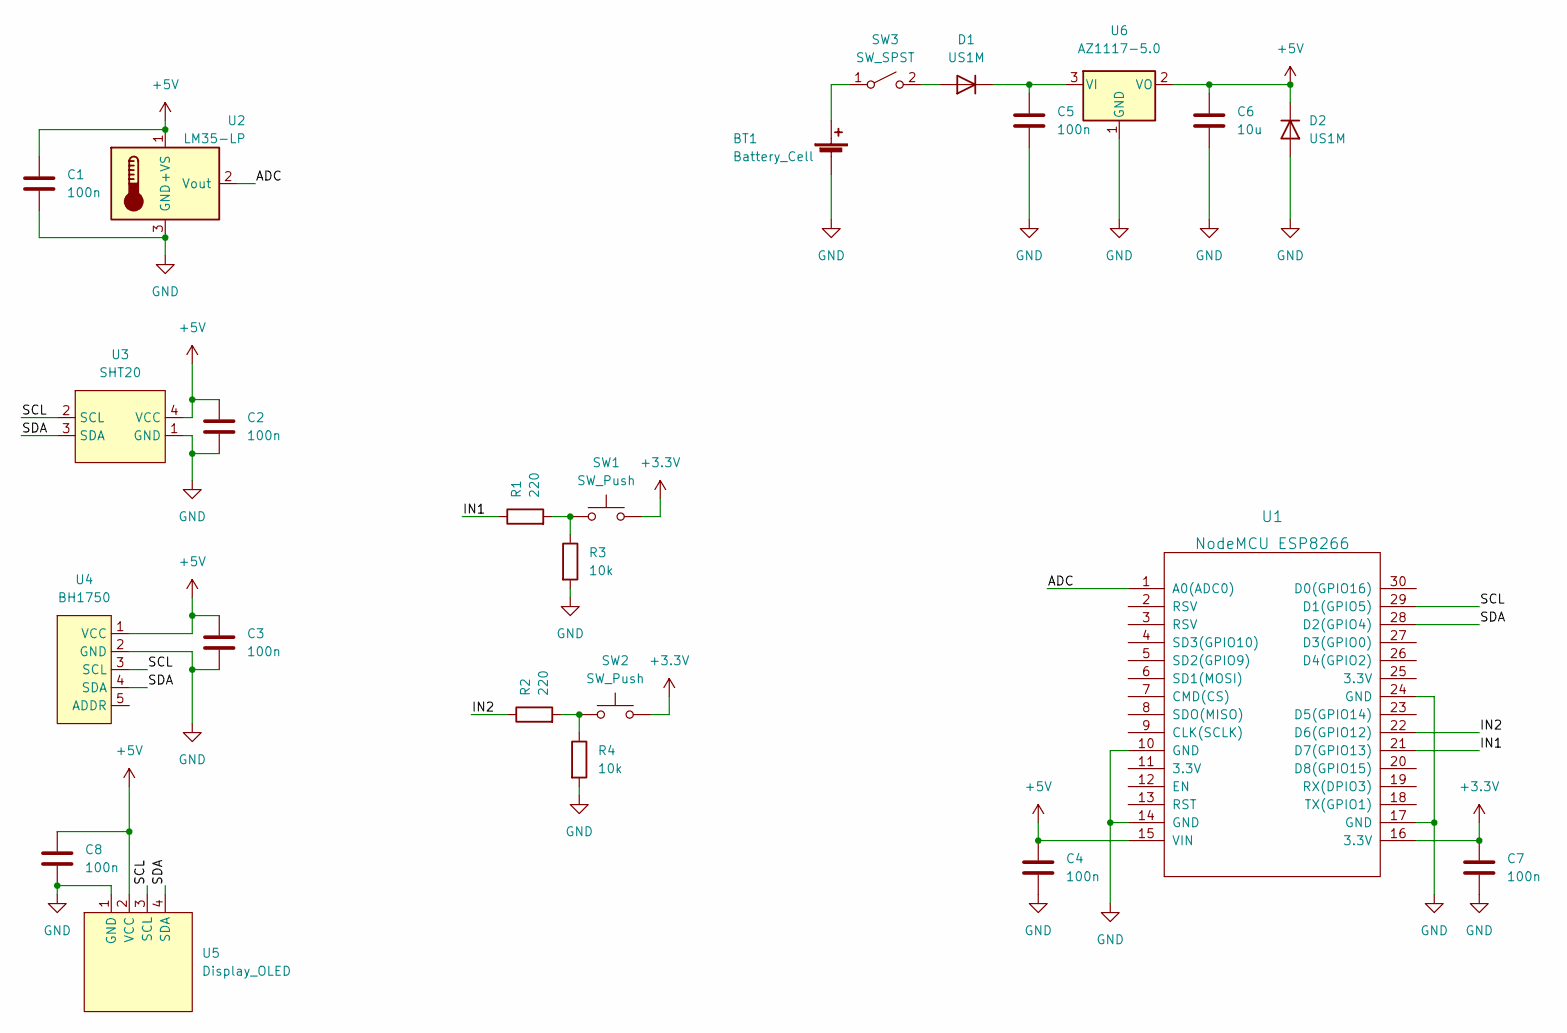
[picture p59: schematic ProyectoFinal.kicad_sch, Sensor Integral para el cuidado de plantas]

Parts:
BT1: Battery_Cell; Molex_KK-254_AE-6410-02A_1x02_P2.54mm_Vertical
C1, C2, C3, C4, C5, C7, C8: 100n; C_1206_3216Metric_Pad1.33x1.80mm_HandSolder
C6: 10u; CP_Radial_D5.0mm_P2.50mm
D1, D2: US1M; D_SMA
R1, R2: 220; R_1206_3216Metric_Pad1.30x1.75mm_HandSolder
R3, R4: 10k; R_1206_3216Metric_Pad1.30x1.75mm_HandSolder
SW1, SW2: SW_Push; SW_PUSH_6mm_H5mm
SW3: SW_SPST; SW_E-Switch_EG2219_DPDT_Angled
U1: NodeMCU ESP8266; ESP12F-Devkit-V3
U2: LM35-LP; TO-92_Inline_Wide
U3: SHT20; PinSocket_1x04_P2.54mm_Vertical
U4: BH1750; PinSocket_1x05_P2.54mm_Vertical
U5: Display_OLED; PinSocket_1x04_P2.54mm_Vertical
U6: AZ1117-5.0; SOT-223

Connections:
+3V3: C7.1, SW1.2, SW2.2, U1.16 (3.3V)
+5V: C1.1, C2.1, C3.1, C4.1, C6.1, C8.1, D2.1 (K), U1.15 (VIN), U2.1 (+VS), U3.4 (VCC), U4.1 (VCC), U5.2 (VCC), U6.2 (VO)
/ADC: U1.1 (A0(ADC0)), U2.2 (Vout)
/IN1: R1.1, U1.21 (D7(GPIO13))
/IN2: R2.1, U1.22 (D6(GPIO12))
/SCL: U1.29 (D1(GPIO5)), U3.2 (SCL), U4.3 (SCL), U5.3 (SCL)
/SDA: U1.28 (D2(GPIO4)), U3.3 (SDA), U4.4 (SDA), U5.4 (SDA)
GND: BT1.2 (-), C1.2, C2.2, C3.2, C4.2, C5.2, C6.2, C7.2, C8.2, D2.2 (A), R3.2, R4.2, U1.10 (GND), U1.14 (GND), U1.17 (GND), U1.24 (GND), U2.3 (GND), U3.1 (GND), U4.2 (GND), U5.1 (GND), U6.1 (GND)
unnamed: BT1.1 (+), SW3.1 (A)
unnamed: C5.1, D1.1 (K), U6.3 (VI)
unnamed: D1.2 (A), SW3.2 (B)
unnamed: R1.2, R3.1, SW1.1
unnamed: R2.2, R4.1, SW2.1

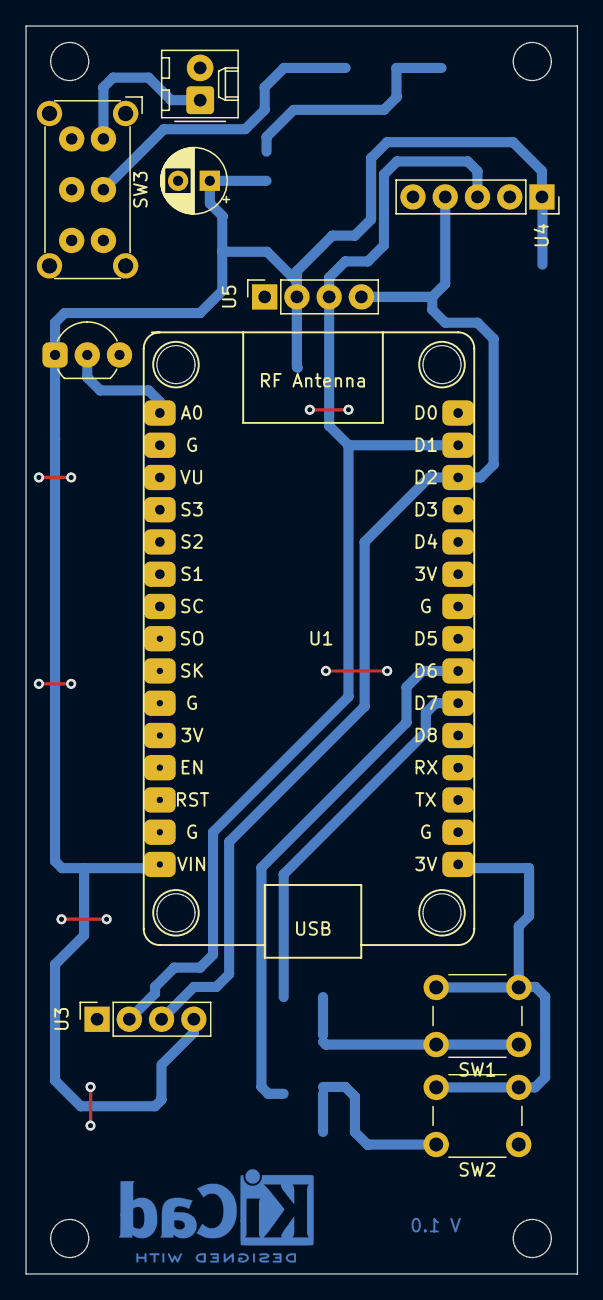
[picture p60: board ProyectoFinal.kicad_pcb from above]

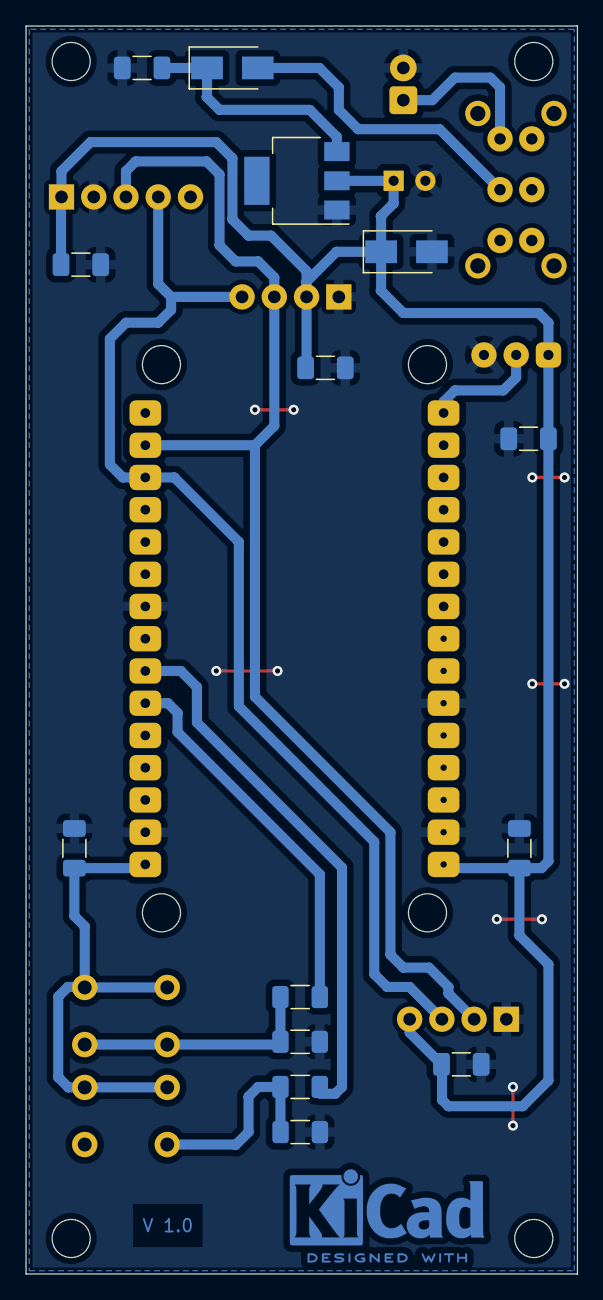
[picture p61: board ProyectoFinal.kicad_pcb from below]

Board: 2 copper layers, 43.4 x 98.3 mm, 24 parts (14 on the bottom side), 13 nets.
