jpgrismeyer/ProyectoFinal/Sensor integral para el cuidado de plantas-20250406T194602Z-001/Sensor integral para el cuidado de plantas/Etapa I/Diseño PCB/Diseño_Prototipo_1/Diseño_Prototipo_1.kicad_pcb

## KiCad design Sensor integral para el cuidado de plantas-20250406T194602Z-001/Sensor integral para el cuidado de plantas/Etapa I/Diseño PCB/Diseño_Prototipo_1/Diseño_Prototipo_1.kicad_pcb (2025-04-06)

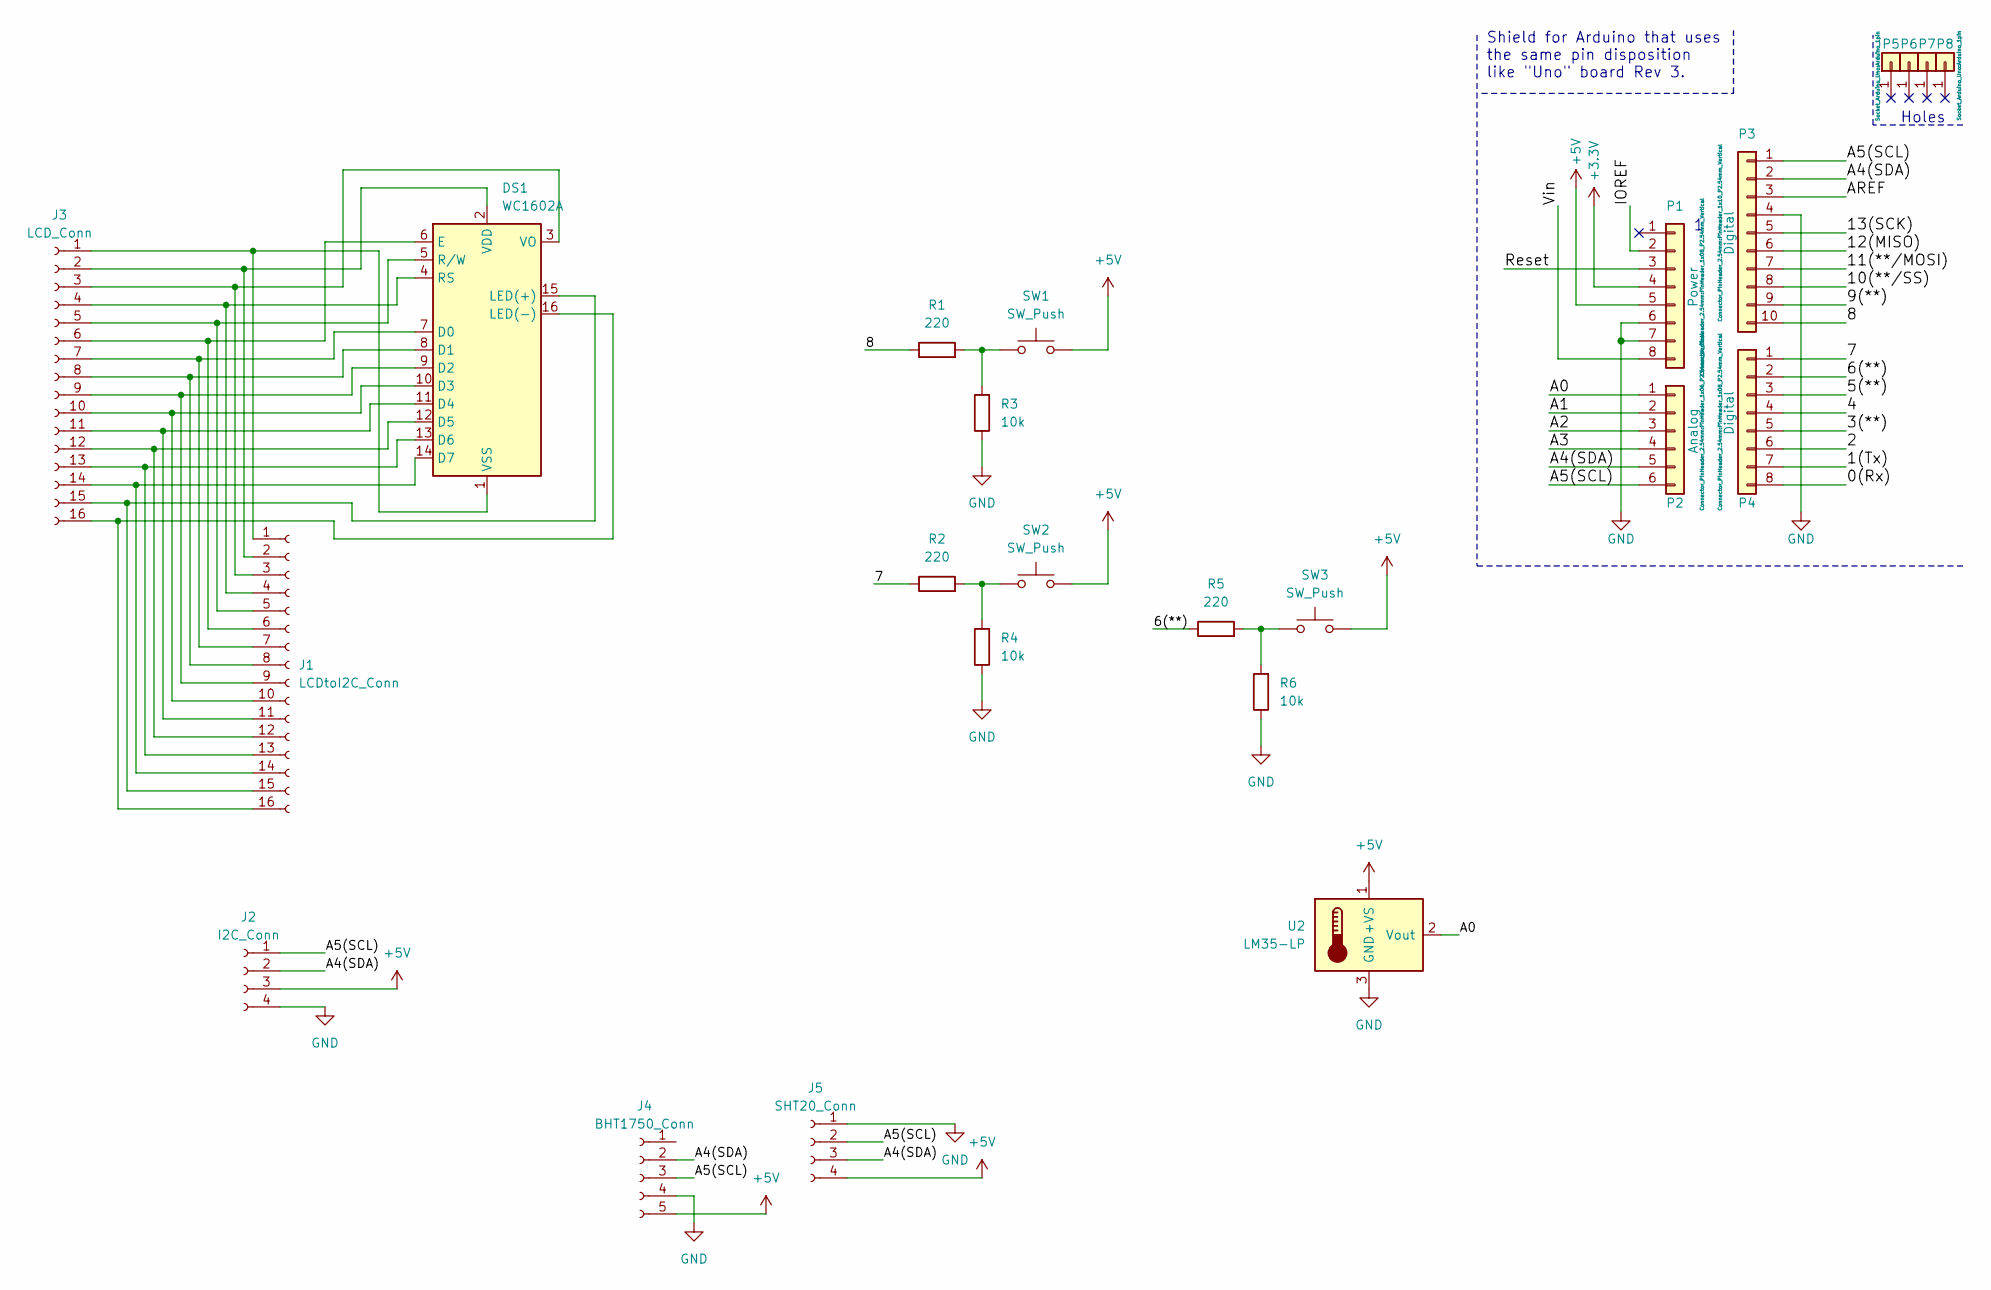
[picture p62: schematic Diseño_Prototipo_1.kicad_sch]

Parts:
DS1: WC1602A
J1: LCDtoI2C_Conn; PinSocket_1x16_P2.54mm_Vertical
J2: I2C_Conn; PinSocket_1x04_P2.54mm_Vertical
J3: LCD_Conn; PinSocket_1x16_P2.54mm_Vertical
J4: BHT1750_Conn; PinSocket_1x05_P2.54mm_Horizontal
J5: SHT20_Conn; PinSocket_1x04_P2.54mm_Vertical
P1: Power; PinHeader_1x08_P2.54mm_Vertical
P2: Analog; PinHeader_1x06_P2.54mm_Vertical
P3: Digital; PinHeader_1x10_P2.54mm_Vertical
P4: Digital; PinHeader_1x08_P2.54mm_Vertical
P5, P6, P7, P8: CONN_01X01; Arduino_1pin
R1, R2, R5: 220; R_Axial_DIN0207_L6.3mm_D2.5mm_P10.16mm_Horizontal
R3, R4, R6: 10k; R_Axial_DIN0207_L6.3mm_D2.5mm_P10.16mm_Horizontal
SW1, SW2, SW3: SW_Push; SW_PUSH_6mm
U2: LM35-LP; TO-92_Inline_Horizontal1

Connections:
+3V3: P1.4
+5V: J2.3, J4.5, J5.4, P1.5, SW1.2, SW2.2, SW3.2, U2.1 (+VS)
/0(Rx): P4.8
/1(Tx): P4.7
/2: P4.6
/3(**): P4.5
/4: P4.4
/5(**): P4.3
/6(**): P4.2, R5.1
/7: P4.1, R2.1
/8: P3.10, R1.1
/9(**): P3.9
/10(**/SS): P3.8
/11(**/MOSI): P3.7
/12(MISO): P3.6
/13(SCK): P3.5
/A0: P2.1, U2.2 (Vout)
/A1: P2.2
/A2: P2.3
/A3: P2.4
/A4(SDA): J2.2, J4.2, J5.3, P2.5, P3.2
/A5(SCL): J2.1, J4.3, J5.2, P2.6, P3.1
/AREF: P3.3
/IOREF: P1.2
/Reset: P1.3
/Vin: P1.8
GND: J2.4, J4.4, J5.1, P1.6, P1.7, P3.4, R3.1, R4.1, R6.1, U2.3 (GND)
unnamed: DS1.1 (VSS), J1.1, J3.1
unnamed: DS1.2 (VDD), J1.2, J3.2
unnamed: DS1.3 (VO), J1.3, J3.3
unnamed: DS1.4 (RS), J1.4, J3.4
unnamed: DS1.5 (R/W), J1.5, J3.5
unnamed: DS1.6 (E), J1.6, J3.6
unnamed: DS1.7 (D0), J1.7, J3.7
unnamed: DS1.8 (D1), J1.8, J3.8
unnamed: DS1.9 (D2), J1.9, J3.9
unnamed: DS1.10 (D3), J1.10, J3.10
unnamed: DS1.11 (D4), J1.11, J3.11
unnamed: DS1.12 (D5), J1.12, J3.12
unnamed: DS1.13 (D6), J1.13, J3.13
unnamed: DS1.14 (D7), J1.14, J3.14
unnamed: DS1.15 (LED(+)), J1.15, J3.15
unnamed: DS1.16 (LED(-)), J1.16, J3.16
unnamed: R1.2, R3.2, SW1.1
unnamed: R2.2, R4.2, SW2.1
unnamed: R5.2, R6.2, SW3.1

Notes on the sheet:
Holes
Shield for Arduino that uses the same pin disposition like "Uno" board Rev 3.

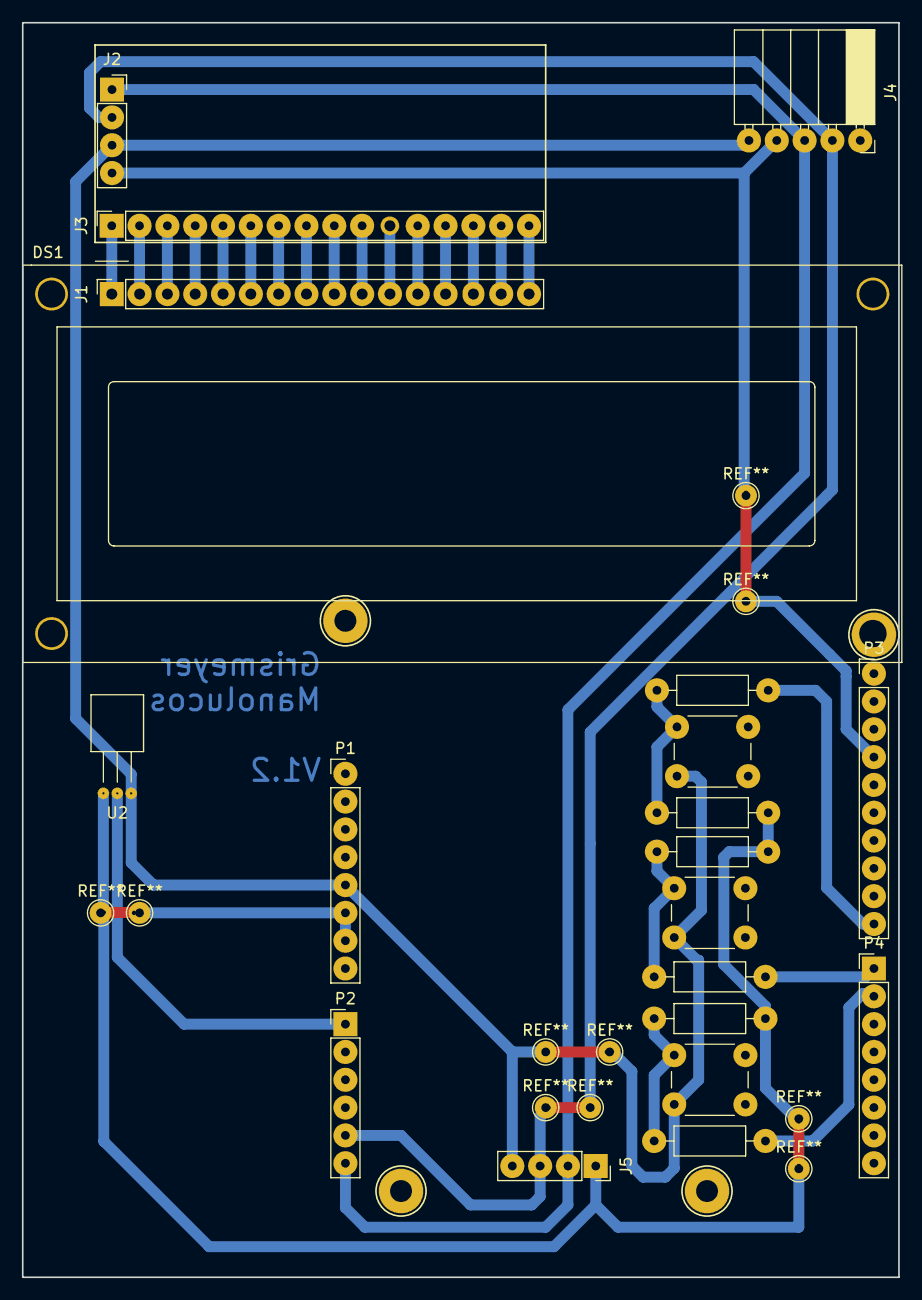
[picture p63: board Diseño_Prototipo_1.kicad_pcb from above]

Board: 2 copper layers, 80.0 x 114.6 mm, 24 parts (0 on the bottom side), 27 nets.
