jpgrismeyer/ProyectoFinal/(commit log)

2025-04-06 Proyecto Final: Sensor integral para el cuidado de plantas
    [Caratula.xlsx, Diseño_Prototipo_1.kicad_pcb, Diseño_Prototipo_1.kicad_sch, Materiales.xlsx, ProyectoFinal.kicad_pcb, ProyectoFinal.kicad_sch, Sensores.xlsx, proyecto final base b-Body.stl]
2025-04-06 Proyecto presentado el 8/7/22
